mapa4686/resume/sleeve assembly.JPG

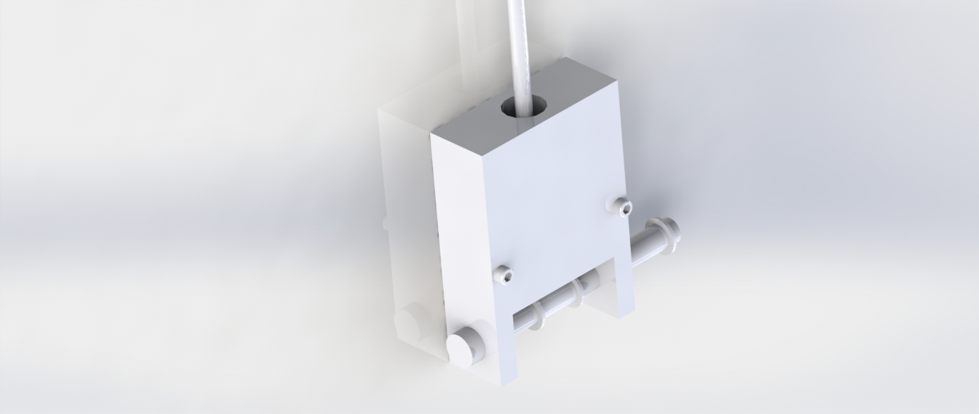
sleeve assembly.JPG
