mapa4686/resume/CHAKR.JPG

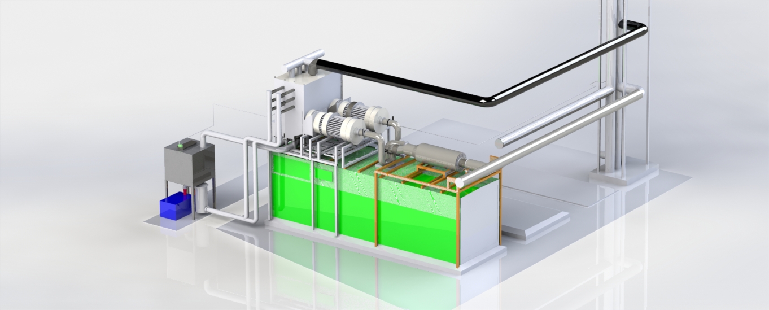
CHAKR.JPG
