mapa4686/resume/canvas.PNG

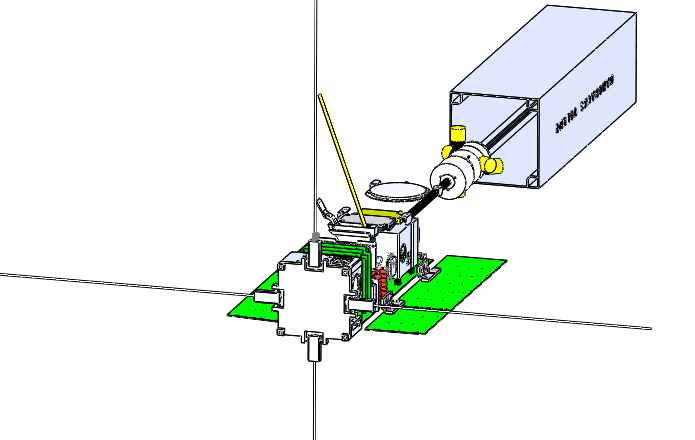
canvas.PNG
