mapa4686/resume/explicit_dynamics_disp.PNG

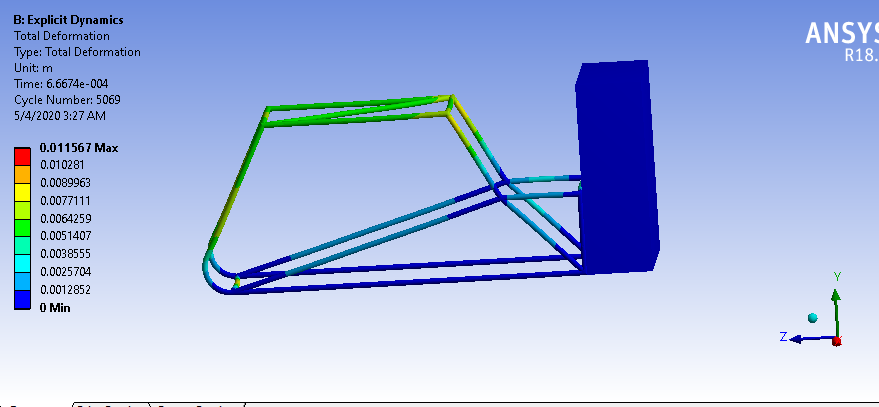
explicit_dynamics_disp.PNG
