mapa4686/resume/th_final frame_v.PNG

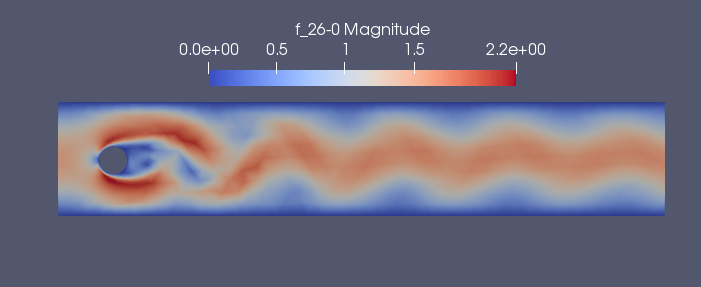
th_final frame_v.PNG
