mapa4686/resume/WhatsApp Image 2020-04-17 at 14.05.21.jpeg

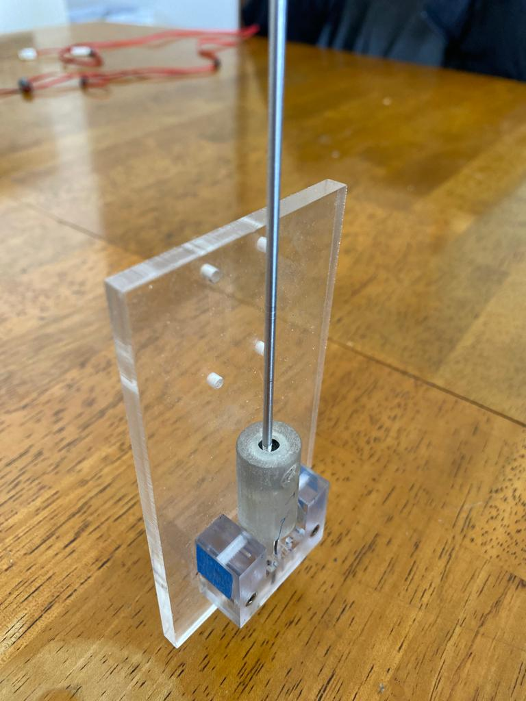
WhatsApp Image 2020-04-17 at 14.05.21.jpeg
