mapa4686/resume/car.SLDPRT

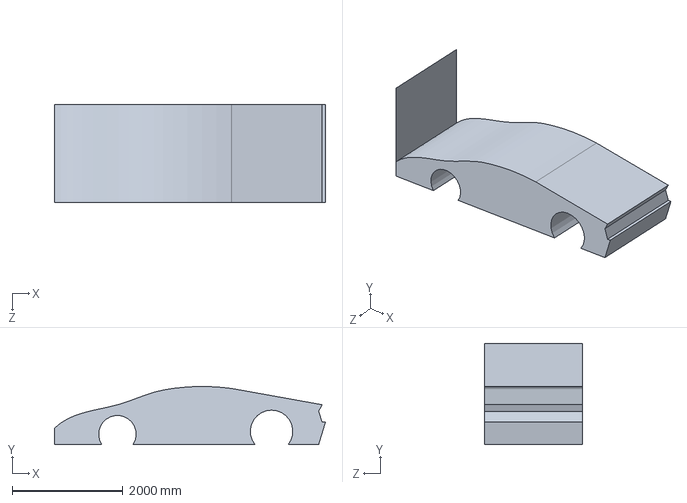
[picture p36: CAD file, 2020-05-08]
car.SLDPRT
4903.3 x 1828.8 x 1778.0 mm
